handro123/E46_Seat_Memory_K-Bus/(commit log)

2023-07-01 Gerber file to make PCB
2023-07-01 Added details about PCB
